kemotz/GD32F1x0-dev-brd/render.PNG

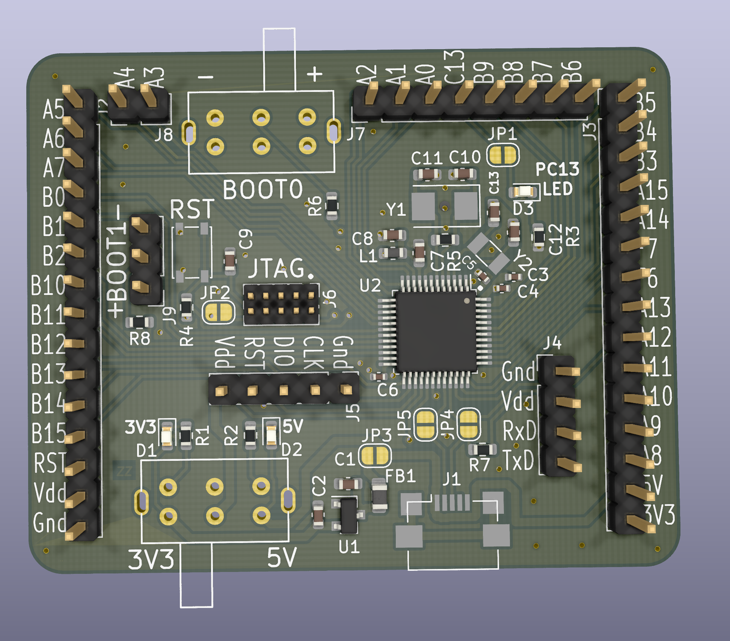
render.PNG
