kemotz/GD32F1x0-dev-brd/README.md

# GD32F1x0-dev-brd
 
GigaDevice GD32F1x0 value line MCU development board. The board supports F130/150/170/190 however the assembly files are created for F190 using JLCPCB service.
