kemotz/GD32F1x0-dev-brd/F190-JLC-assembly/GD32F190-dev-brd-BOM_JLCSMT.xlsx

Comment | Designator | Footprint | LCSC Part #（optional）
1k5 | R7 | R_0603_1608Metric | C22843
1u | C1,C2,C7 | C_0603_1608Metric | C15849
100n | C8,C9 | C_0603_1608Metric | C14663
30p | C10,C11 | C_0603_1608Metric | C22397
10p | C12,C13 | C_0603_1608Metric | C1634
Orange | D1 | LED_0603_1608Metric | C72038
Red | D2 | LED_0603_1608Metric | C2286
Green | D3 | LED_0603_1608Metric | C72043
100R | FB1 | L_0805_2012Metric | C1015
27n | L1 | L_0603_1608Metric | C12100
2k2 | R1 | R_0603_1608Metric | C4190
3k3 | R2,R3 | R_0603_1608Metric | C22978
10k | R4 | R_0603_1608Metric | C25804
1M | R5 | R_0603_1608Metric | C22935
100k | R6,R8 | R_0603_1608Metric | C25803
XC6206PxxxMR | U1 | SOT-23 | C5446
GD32F190C8Tx | U2 | LQFP-48_7x7mm_P0.5mm | C84217
8MHz | Y1 | Crystal_SMD_5032-2Pin_5.0x3.2mm | C115962
32.768kHz | Y2 | Crystal_SMD_3215-2Pin_3.2x1.5mm | C32346
4u7 | C3 | C_0402_1005Metric | C23733
100n | C4,C5,C6 | C_0402_1005Metric | C1525
USB_B_Micro | J1 | USB_Micro-B_MicroQTJ | C404968
