kemotz/GD32F1x0-dev-brd/GD32F1x0-dev-brd-sch.pdf

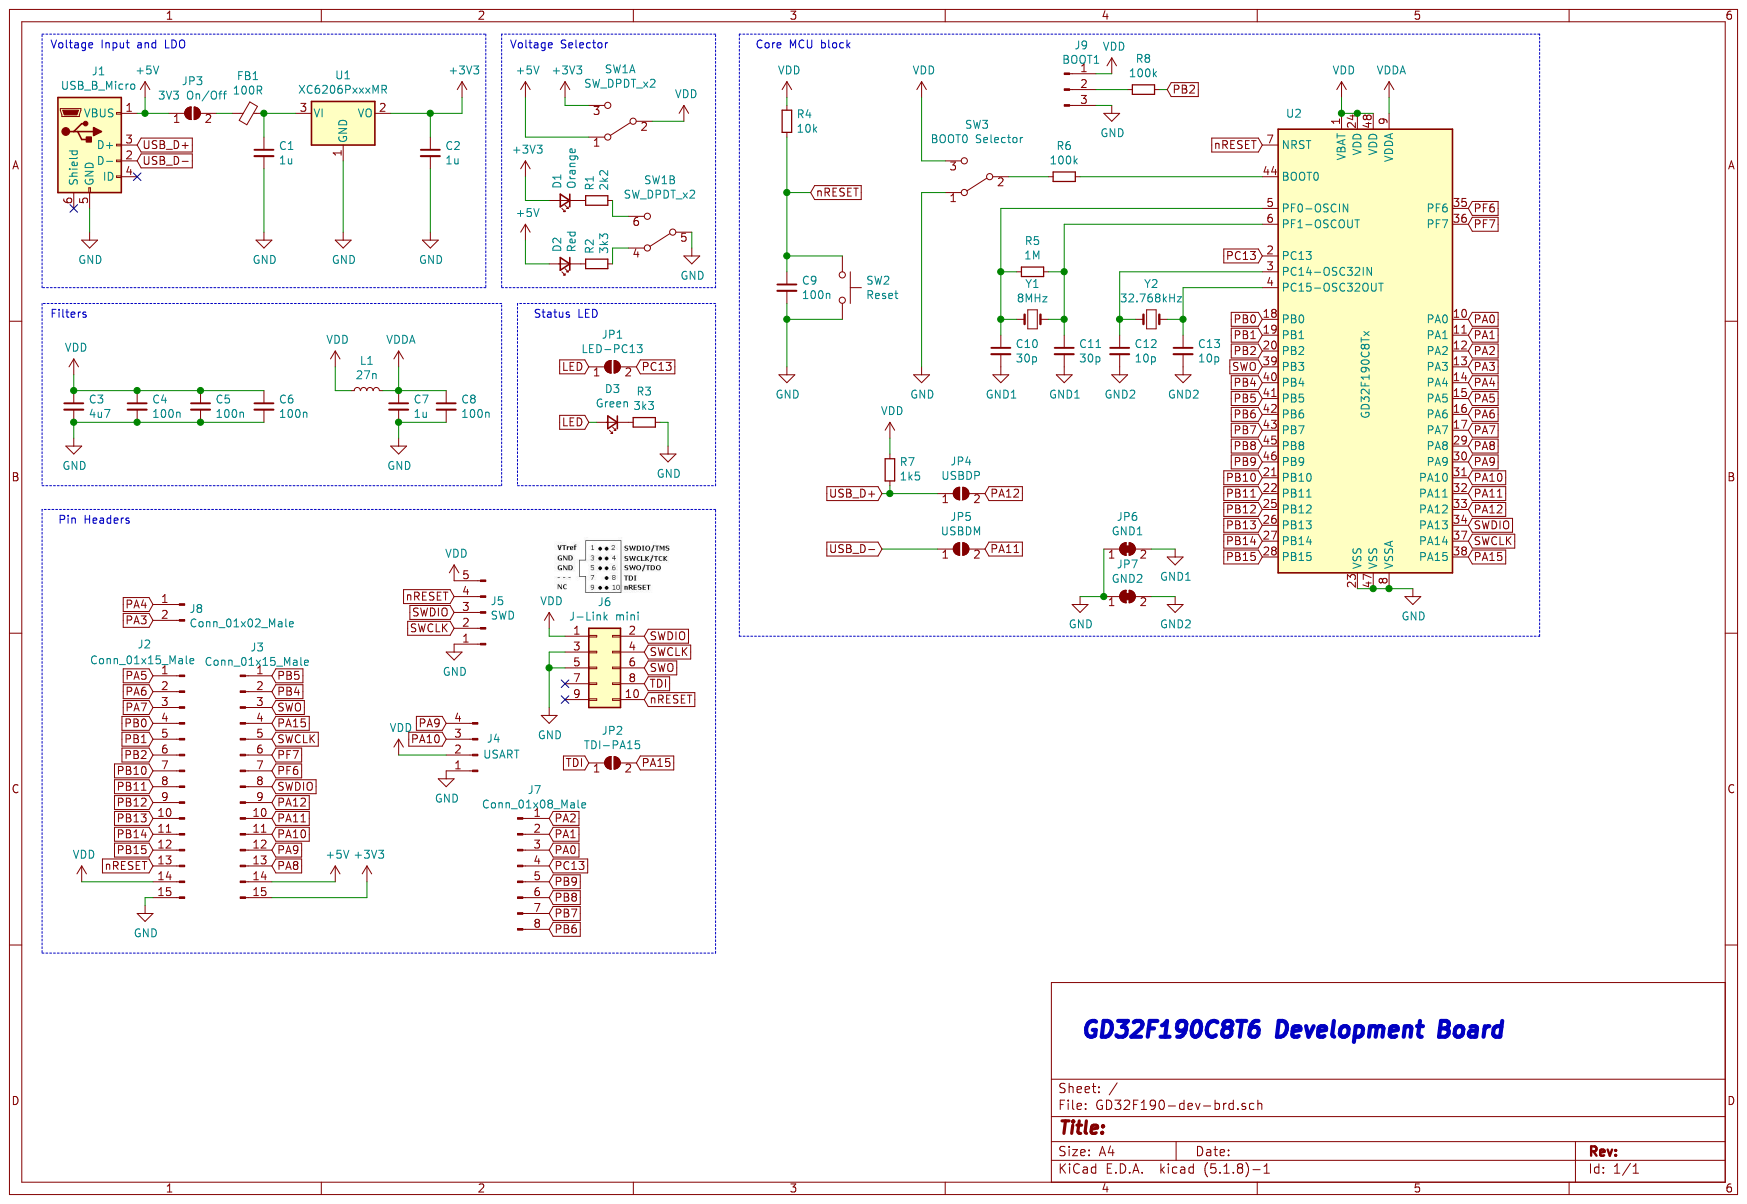
[picture p2: page 1]
