kemotz/GD32F1x0-dev-brd/GD32F190-dev-brd.kicad_pcb

## KiCad design GD32F190-dev-brd.kicad_pcb (2021-06-10)

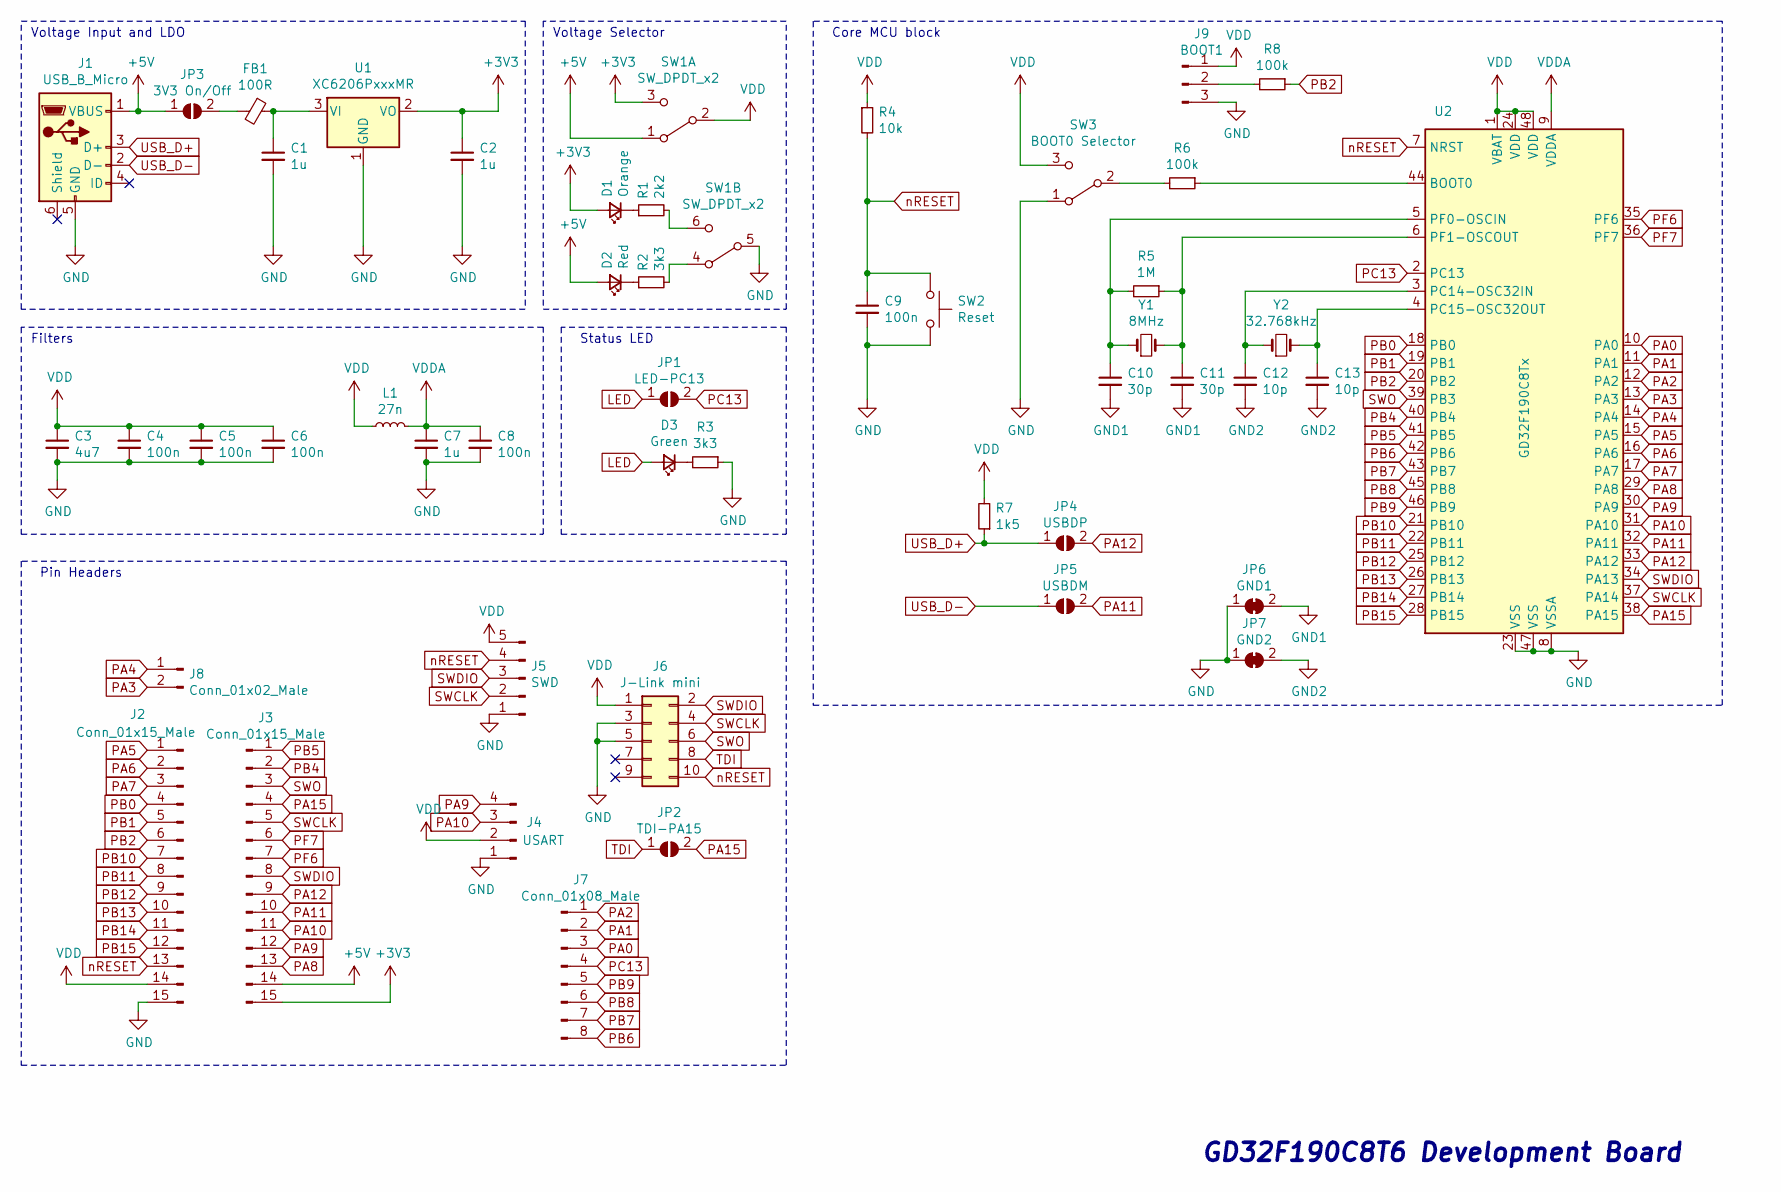
[picture p3: schematic GD32F190-dev-brd.sch]

Parts:
C1, C2, C7: 1u; C_0603_1608Metric
C3: 4u7; C_0402_1005Metric
C4, C5, C6: 100n; C_0402_1005Metric
C8, C9: 100n; C_0603_1608Metric
C10, C11: 30p; C_0603_1608Metric
C12, C13: 10p; C_0603_1608Metric
D1: Orange; LED_0603_1608Metric
D2: Red; LED_0603_1608Metric
D3: Green; LED_0603_1608Metric
FB1: 100R; L_0805_2012Metric
J1: USB_B_Micro; USB_Micro-B_MicroQTJ
J2, J3: Conn_01x15_Male; PinHeader_1x15_P2.54mm_Vertical
J4: USART; PinHeader_1x04_P2.54mm_Vertical
J5: SWD; PinHeader_1x05_P2.54mm_Vertical
J6: J-Link mini; PinHeader_2x05_P1.27mm_Vertical
J7: Conn_01x08_Male; PinHeader_1x08_P2.54mm_Vertical
J8: Conn_01x02_Male; PinHeader_1x02_P2.54mm_Vertical
J9: BOOT1; PinHeader_1x03_P2.54mm_Vertical
JP1: LED-PC13; SolderJumper-2_P1.3mm_Open_RoundedPad1.0x1.5mm
JP2: TDI-PA15; SolderJumper-2_P1.3mm_Open_RoundedPad1.0x1.5mm
JP3: 3V3 On/Off; SolderJumper-2_P1.3mm_Open_RoundedPad1.0x1.5mm
JP4: USBDP; SolderJumper-2_P1.3mm_Open_RoundedPad1.0x1.5mm
JP5: USBDM; SolderJumper-2_P1.3mm_Open_RoundedPad1.0x1.5mm
JP6: GND1; GND-bridge
JP7: GND2; GND-bridge
L1: 27n; L_0603_1608Metric
R1: 2k2; R_0603_1608Metric
R2, R3: 3k3; R_0603_1608Metric
R4: 10k; R_0603_1608Metric
R5: 1M; R_0603_1608Metric
R6, R8: 100k; R_0603_1608Metric
R7: 1k5; R_0603_1608Metric
SW1: SW_DPDT_x2; SK22H03
SW2: Reset; SW_SPST_PTS810
SW3: BOOT0 Selector; SK22H03
U1: XC6206PxxxMR; SOT-23
U2: GD32F190C8Tx; LQFP-48_7x7mm_P0.5mm
Y1: 8MHz; Crystal_SMD_5032-2Pin_5.0x3.2mm
Y2: 32.768kHz; Crystal_SMD_3215-2Pin_3.2x1.5mm

Connections:
+3V3: C2.1, D1.2 (A), J3.15, SW1.3 (C), U1.2 (VO)
+5V: D2.2 (A), J1.1 (VBUS), J3.14, JP3.1 (A), SW1.1 (A)
GND: C1.2, C2.2, C3.2, C4.2, C5.2, C6.2, C7.2, C8.2, C9.2, J1.5 (GND), J2.15, J4.1, J5.1, J6.3, J6.5, J9.3, JP6.1 (A), JP7.1 (A), R3.1, SW1.5 (B), SW2.2, SW3.1 (A), U1.1 (GND), U2.8 (VSSA), U2.23 (VSS), U2.47 (VSS)
GND1: C10.2, C11.2, JP6.2 (B)
GND2: C12.2, C13.2, JP7.2 (B)
LED: D3.2 (A), JP1.1 (A)
unnamed: C1.1, FB1.1, U1.3 (VI)
unnamed: C10.1, R5.2, U2.5 (PF0-OSCIN), Y1.1
unnamed: C11.1, R5.1, U2.6 (PF1-OSCOUT), Y1.2
unnamed: C12.1, U2.3 (PC14-OSC32IN), Y2.1
unnamed: C13.1, U2.4 (PC15-OSC32OUT), Y2.2
unnamed: D1.1 (K), R1.1
unnamed: D2.1 (K), R2.1
unnamed: D3.1 (K), R3.2
unnamed: FB1.2, JP3.2 (B)
unnamed: J9.2, R8.2
unnamed: R1.2, SW1.6 (C)
unnamed: R2.2, SW1.4 (A)
unnamed: R6.1, U2.44 (BOOT0)
unnamed: R6.2, SW3.2 (B)
PA0: J7.3, U2.10 (PA0)
PA1: J7.2, U2.11 (PA1)
PA2: J7.1, U2.12 (PA2)
PA3: J8.2, U2.13 (PA3)
PA4: J8.1, U2.14 (PA4)
PA5: J2.1, U2.15 (PA5)
PA6: J2.2, U2.16 (PA6)
PA7: J2.3, U2.17 (PA7)
PA8: J3.13, U2.29 (PA8)
PA9: J3.12, J4.4, U2.30 (PA9)
PA10: J3.11, J4.3, U2.31 (PA10)
PA11: J3.10, JP5.2 (B), U2.32 (PA11)
PA12: J3.9, JP4.2 (B), U2.33 (PA12)
PA15: J3.4, JP2.2 (B), U2.38 (PA15)
PB0: J2.4, U2.18 (PB0)
PB1: J2.5, U2.19 (PB1)
PB2: J2.6, R8.1, U2.20 (PB2)
PB4: J3.2, U2.40 (PB4)
PB5: J3.1, U2.41 (PB5)
PB6: J7.8, U2.42 (PB6)
PB7: J7.7, U2.43 (PB7)
PB8: J7.6, U2.45 (PB8)
PB9: J7.5, U2.46 (PB9)
PB10: J2.7, U2.21 (PB10)
PB11: J2.8, U2.22 (PB11)
PB12: J2.9, U2.25 (PB12)
PB13: J2.10, U2.26 (PB13)
PB14: J2.11, U2.27 (PB14)
PB15: J2.12, U2.28 (PB15)
PC13: J7.4, JP1.2 (B), U2.2 (PC13)
PF6: J3.7, U2.35 (PF6)
PF7: J3.6, U2.36 (PF7)
SWCLK: J3.5, J5.2, J6.4, U2.37 (PA14)
SWDIO: J3.8, J5.3, J6.2, U2.34 (PA13)
SWO: J3.3, J6.6, U2.39 (PB3)
TDI: J6.8, JP2.1 (A)
USB_D+: J1.3 (D+), JP4.1 (A), R7.1
USB_D-: J1.2 (D-), JP5.1 (A)
VDD: C3.1, C4.1, C5.1, C6.1, J2.14, J4.2, J5.5, J6.1, J9.1, L1.1, R4.1, R7.2, SW1.2 (B), SW3.3 (C), U2.1 (VBAT), U2.24 (VDD), U2.48 (VDD)
VDDA: C7.1, C8.1, L1.2, U2.9 (VDDA)
nRESET: C9.1, J2.13, J5.4, J6.10, R4.2, SW2.1, U2.7 (NRST)

Notes on the sheet:
Voltage Input and LDO
Voltage Selector
Filters
Core MCU block
Status LED
Pin Headers
GD32F190C8T6 Development Board

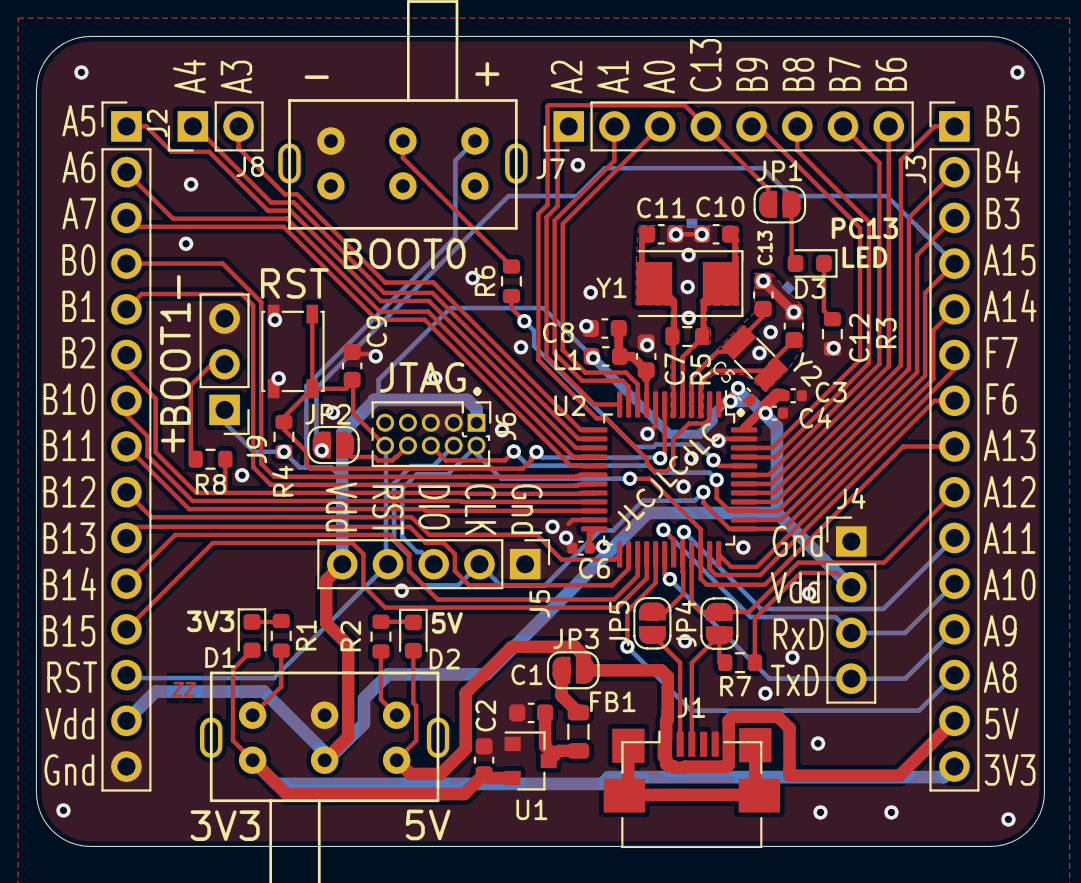
[picture p4: board GD32F190-dev-brd.kicad_pcb from above]

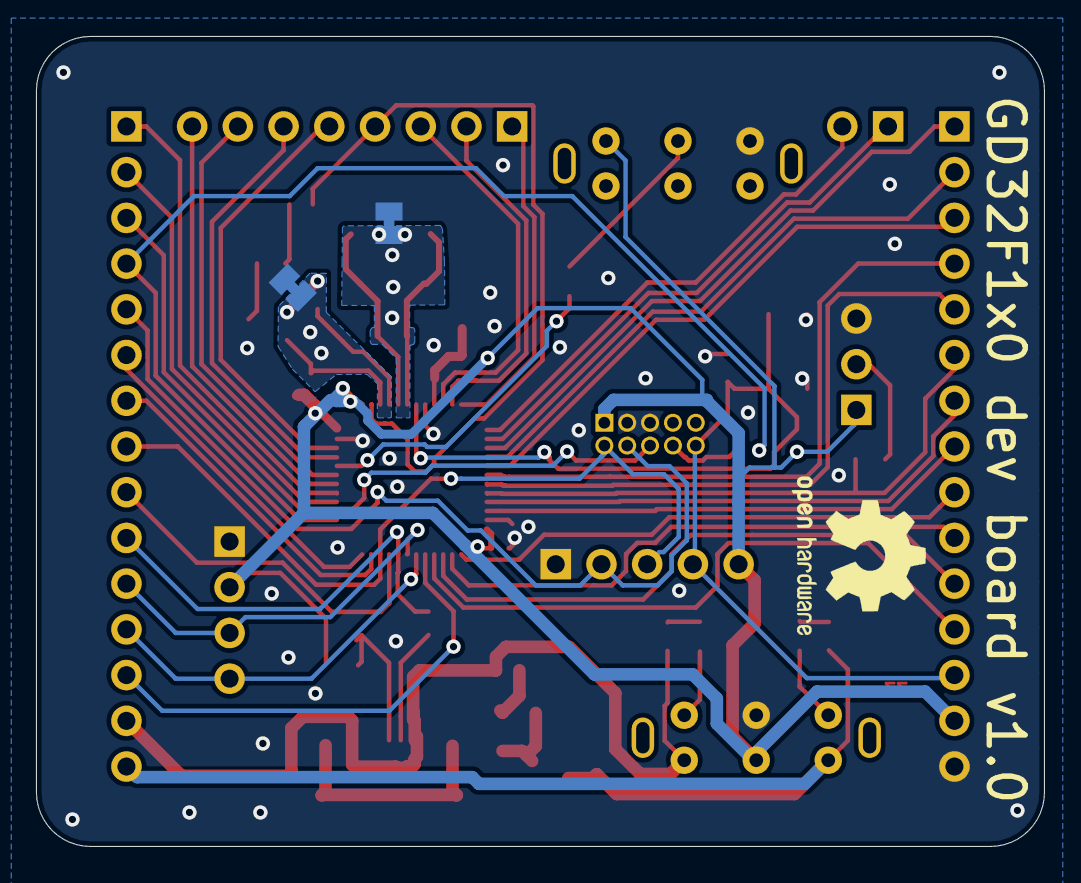
[picture p5: board GD32F190-dev-brd.kicad_pcb from below]

Board: 2 copper layers, 56.0 x 45.0 mm, 49 parts (2 on the bottom side), 61 nets.
