kemotz/GD32F1x0-dev-brd/(commit log)

2021-06-10 v1.0 release
    [GD32F190-dev-brd-BOM_JLCSMT.xlsx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]
2021-06-10 added schematics in pdf format
